ming-bot/Swan-Plan/check middle/外观图.jpg

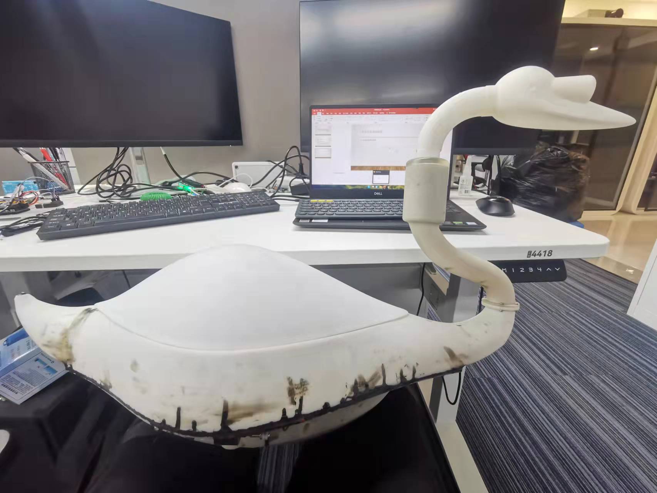
check middle/外观图.jpg
