ming-bot/Swan-Plan/check middle/2.png

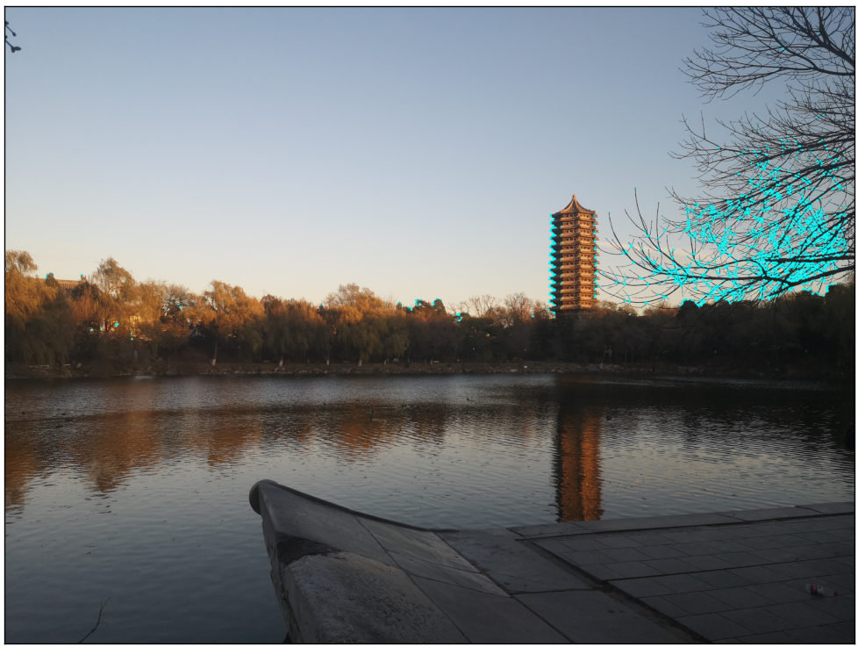
check middle/2.png
