ming-bot/Swan-Plan/README.md

# Swan-Plan

- check-middle中有中期汇报的材料，也是前段工作的总结
- 13.spi_bmi088中为控制代码
- SLAM中为纯图像识别的设想
- socket中为上位机和控制板的通信模块
