ming-bot/Swan-Plan/check middle/top.docx

JY61

communicate

Attitude speed information

Remote control information

Image information

server

By Remote control information

communicate

Raspi4B

Raspi4B

Auto cruise mode

Set PWM wave

communicate

Robomaster

Set Manual control mode

Socket

Process

communicate

communicate
