ming-bot/Swan-Plan/SLAM/系统和摄像头测试.docx

树莓派型号：Raspi4B

安装系统型号：Ubuntu mate 20.04

打开测试摄像头网址：https://chuckmails.medium.com/enable-pi-camera-with-raspberry-pi4-ubuntu-20-10-327208312f6e
