ming-bot/Swan-Plan/check middle/1-canny.png

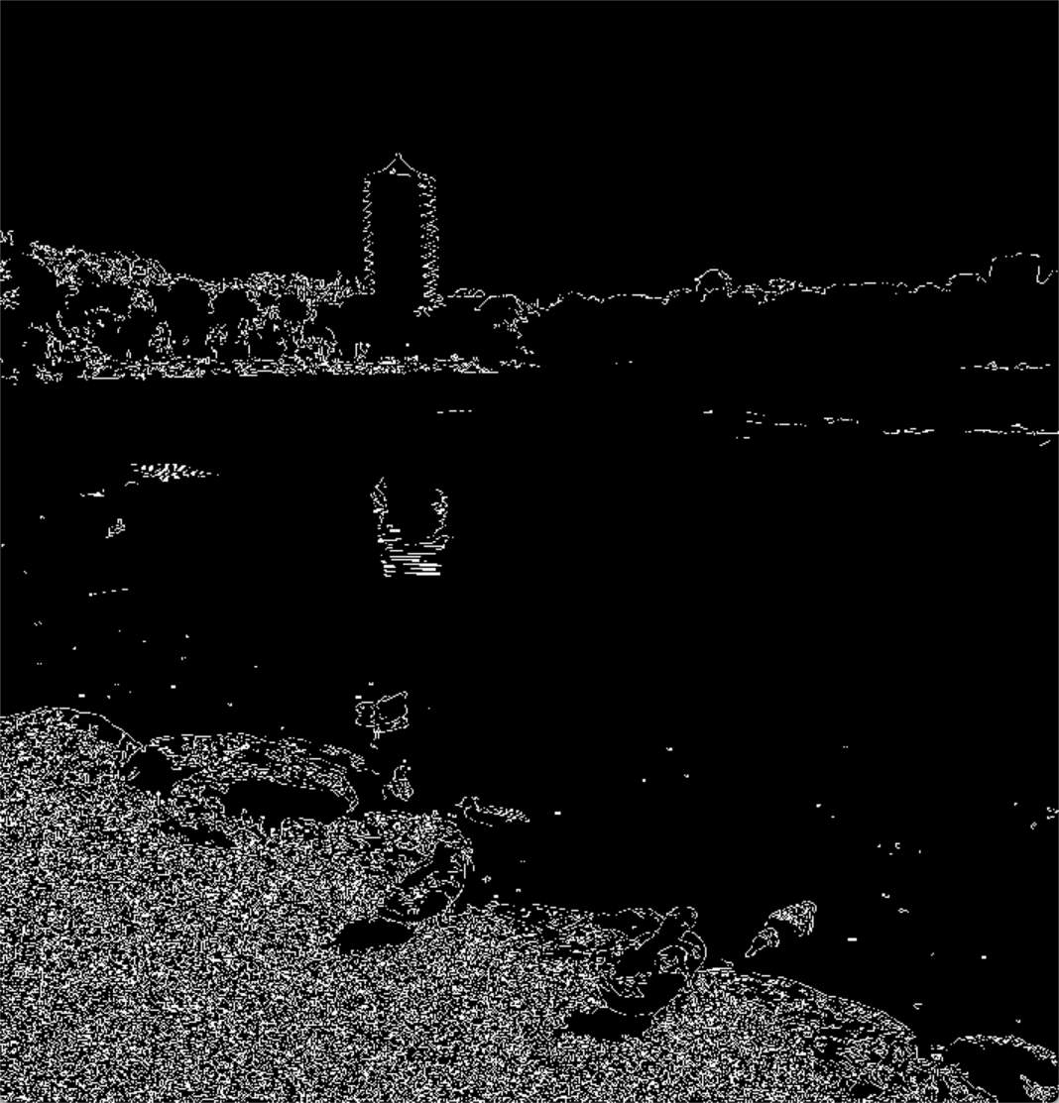
check middle/1-canny.png
