ming-bot/Swan-Plan/check middle/1.png

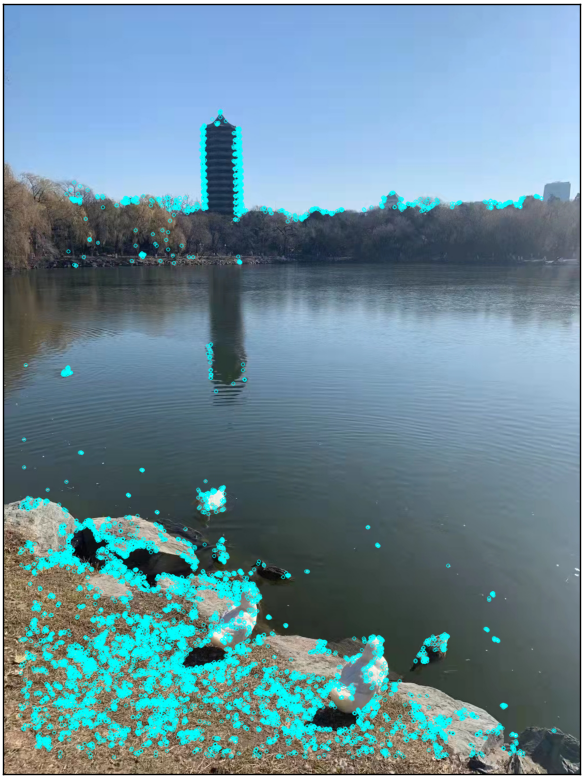
check middle/1.png
