ming-bot/Swan-Plan/check middle/2-canny.png

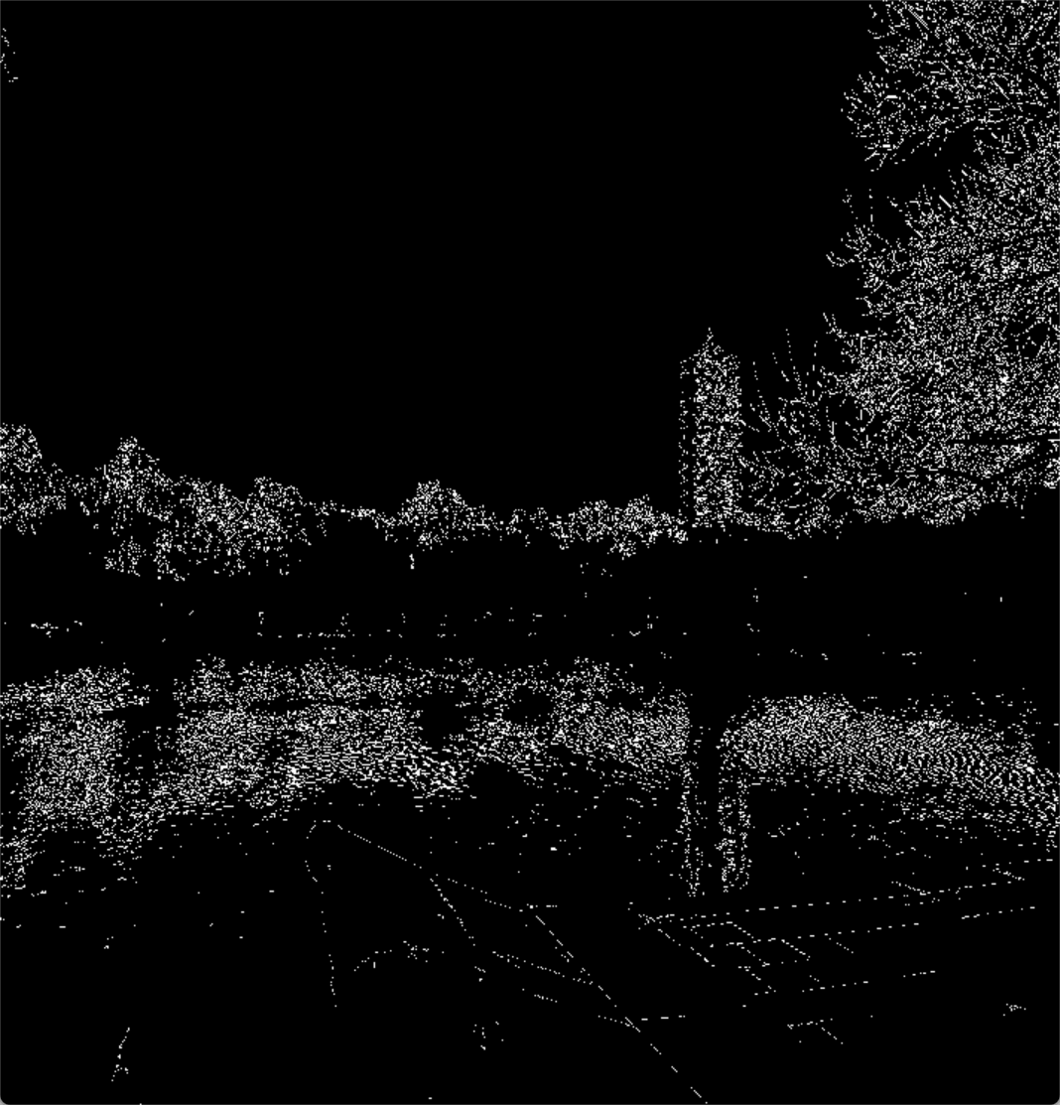
check middle/2-canny.png
