ming-bot/Swan-Plan/check middle/3-canny.png

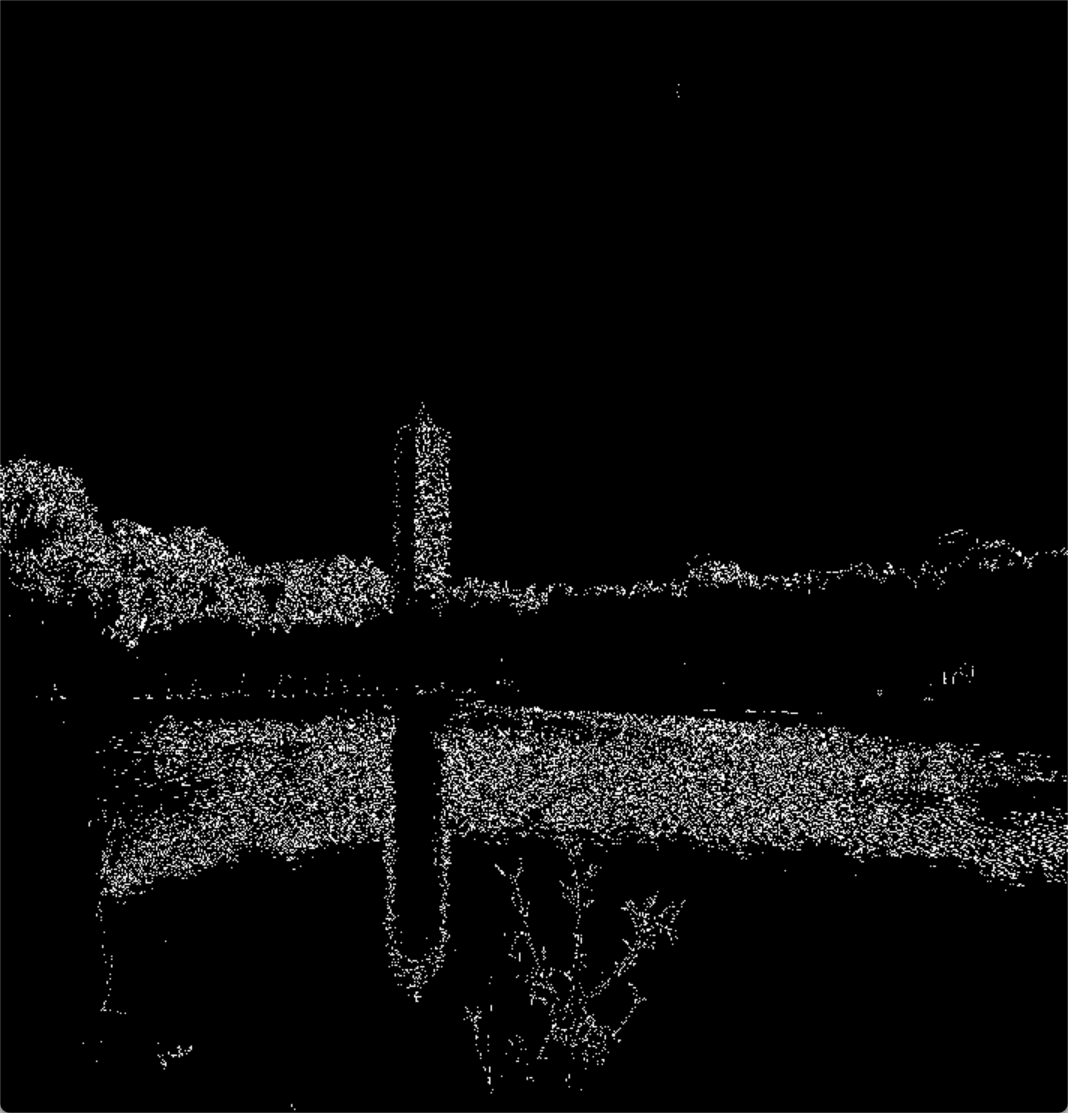
check middle/3-canny.png
