ming-bot/Swan-Plan/check middle/3.png

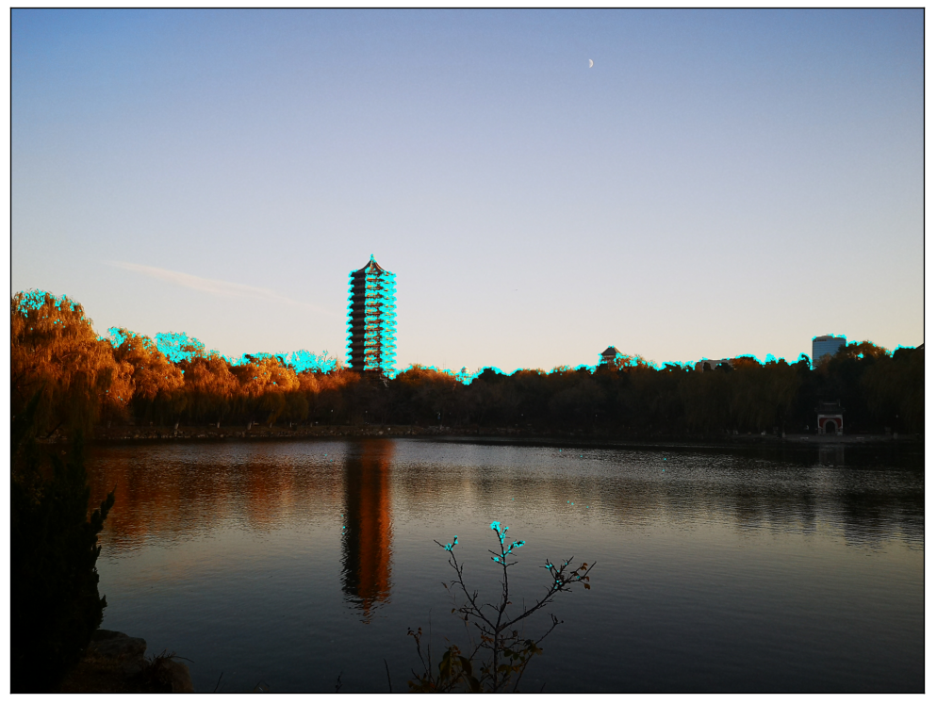
check middle/3.png
