ming-bot/Swan-Plan/check middle/CAD2.png

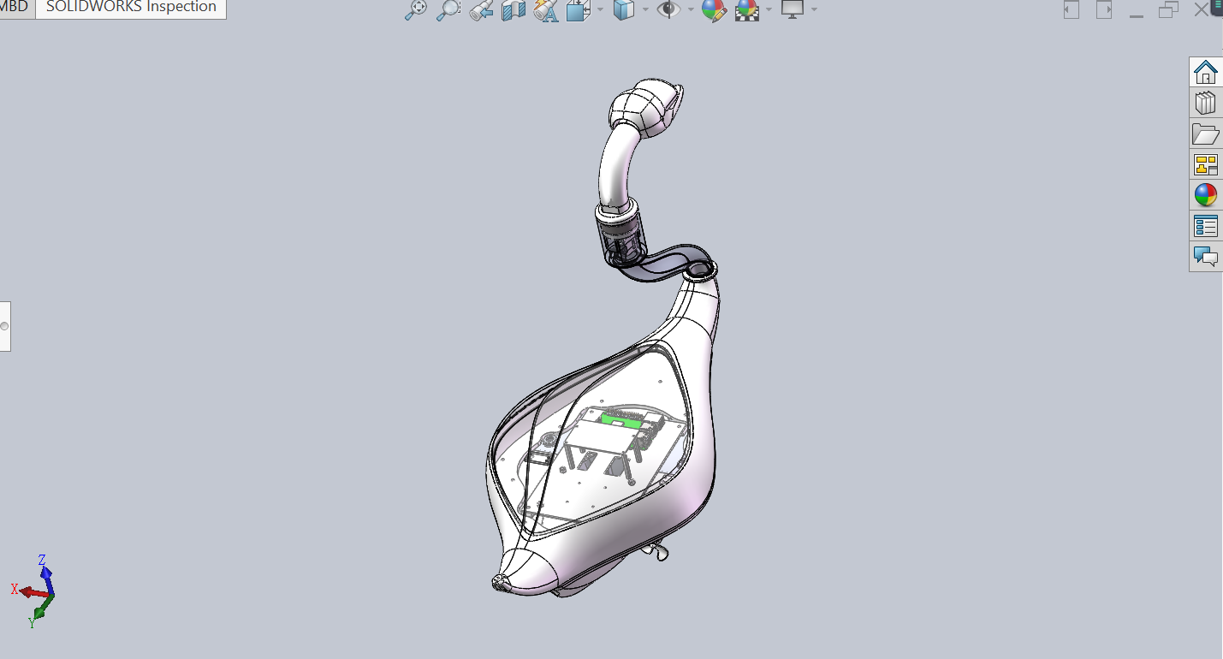
check middle/CAD2.png
