ming-bot/Swan-Plan/check middle/CAD.png

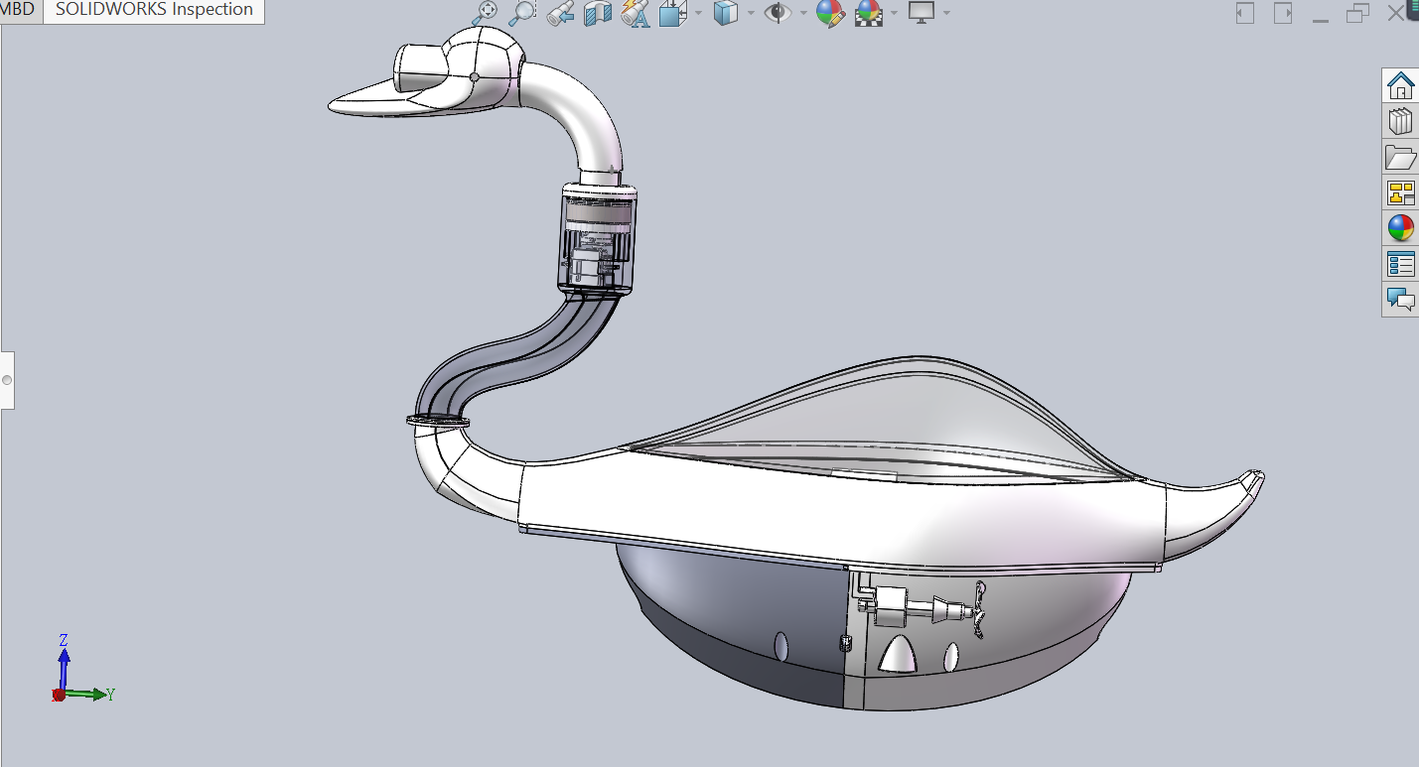
check middle/CAD.png
