ming-bot/Swan-Plan/check middle/Inked1.jpg

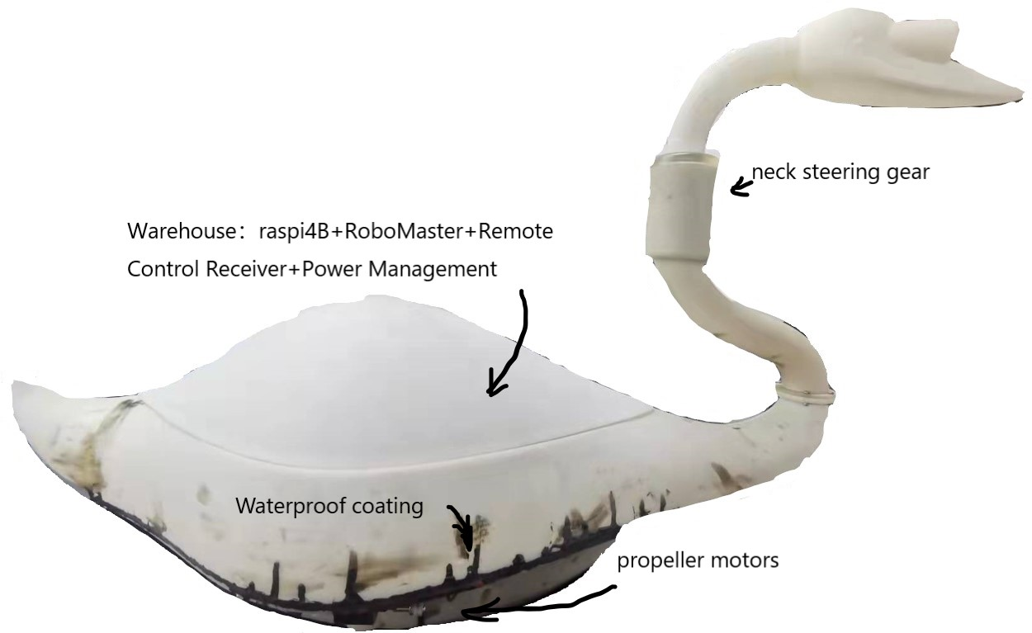
check middle/Inked1.jpg
