ming-bot/Swan-Plan/check middle/top.png

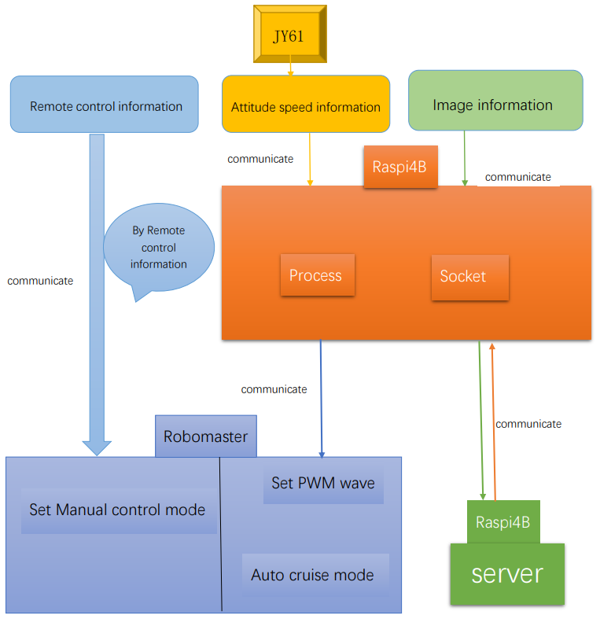
check middle/top.png
