ming-bot/Swan-Plan/SLAM/pre_img/1.jpg

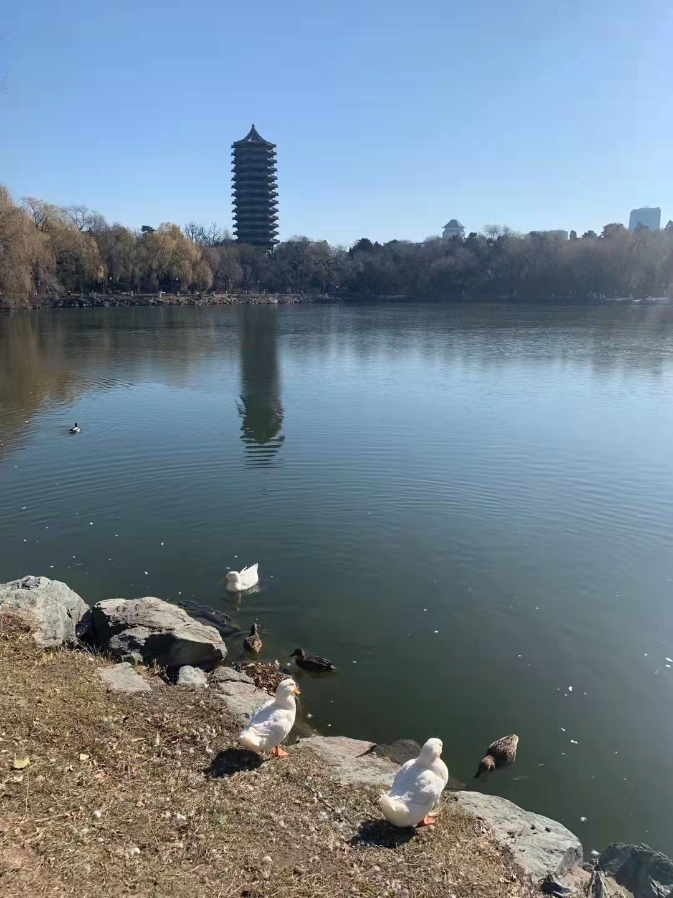
SLAM/pre_img/1.jpg
