ming-bot/Swan-Plan/SLAM/pre_img/3.jpg

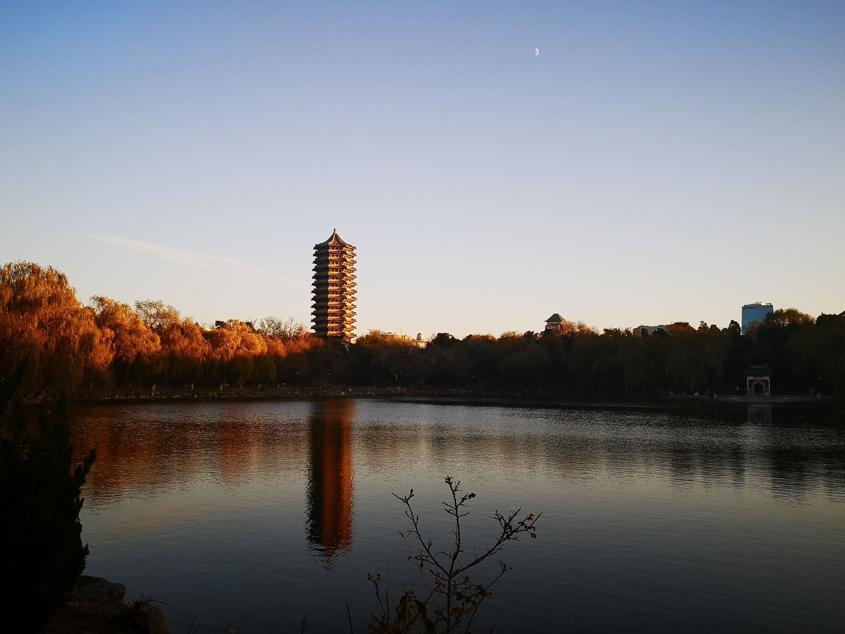
SLAM/pre_img/3.jpg
