ming-bot/Swan-Plan/未名湖天鹅计划/引脚编号.png

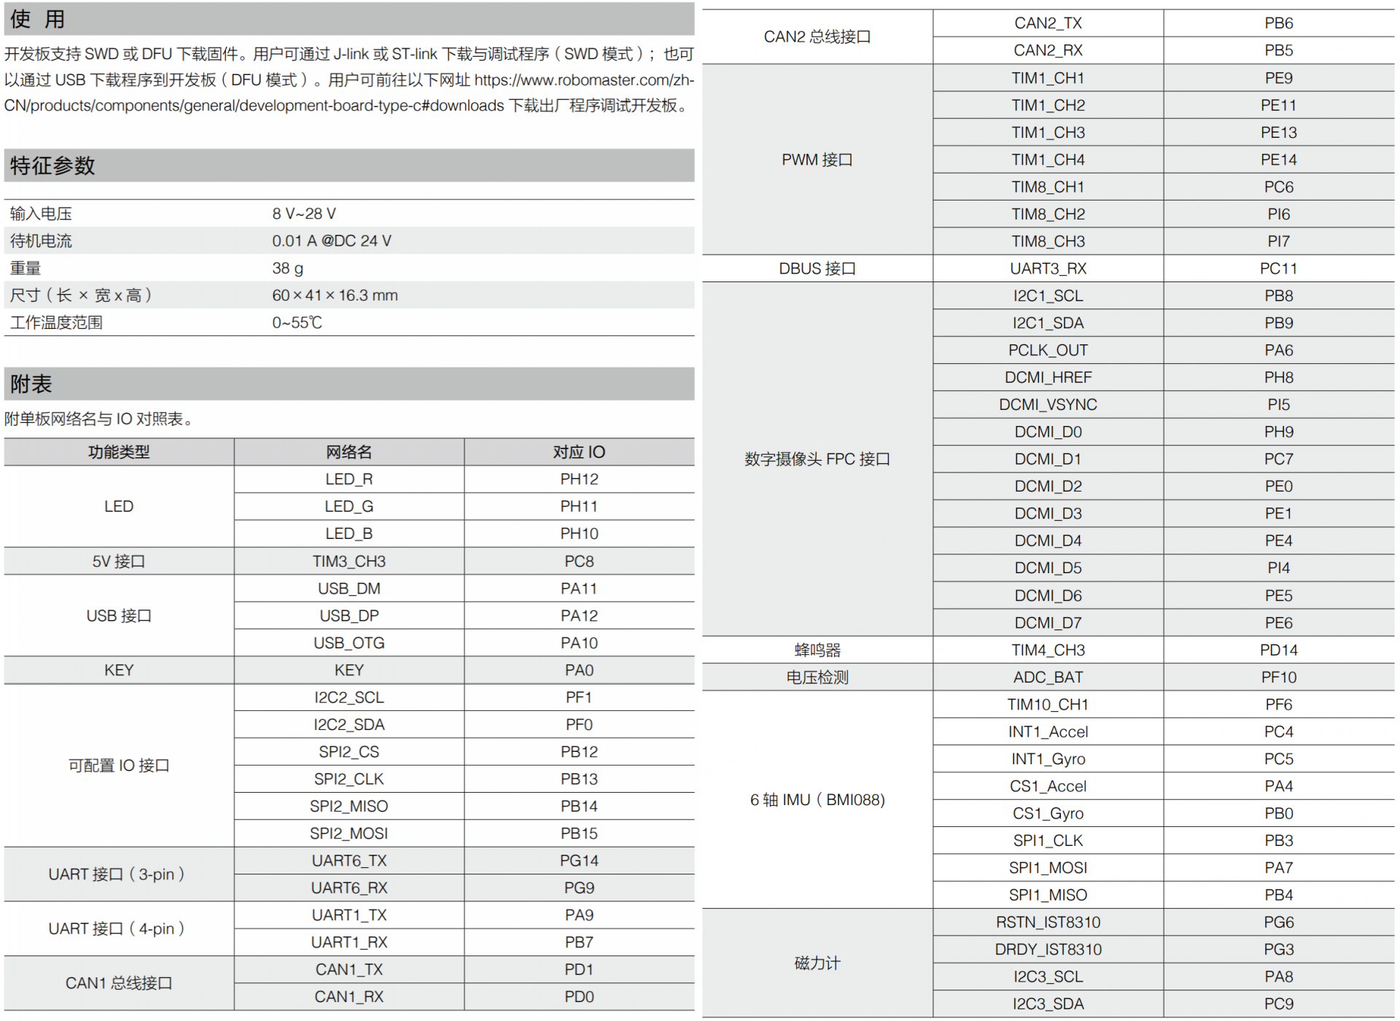
未名湖天鹅计划/引脚编号.png
