ming-bot/Swan-Plan/未名湖天鹅计划/final_building/test_bearing.SLDASM

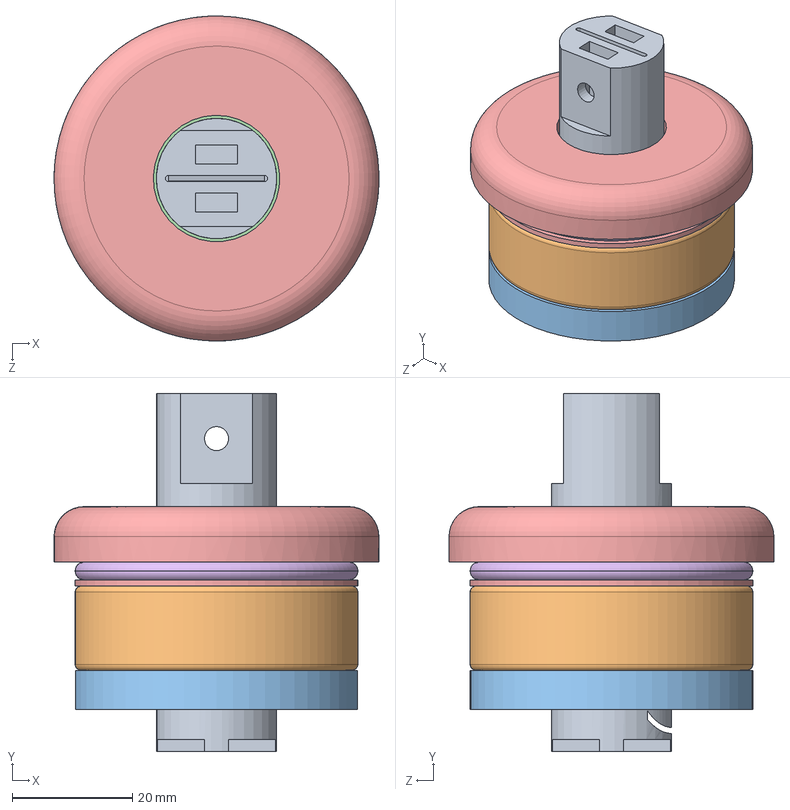
[picture p23: CAD file, 2021-12-15]
未名湖天鹅计划/final_building/test_bearing.SLDASM
54.0 x 59.5 x 54.0 mm
axis
angular contact ball bearing_68_din
Addition_bearing
Seal
cap
Seal_O
