ming-bot/Swan-Plan/未名湖天鹅计划/final_building/Thruster.SLDASM

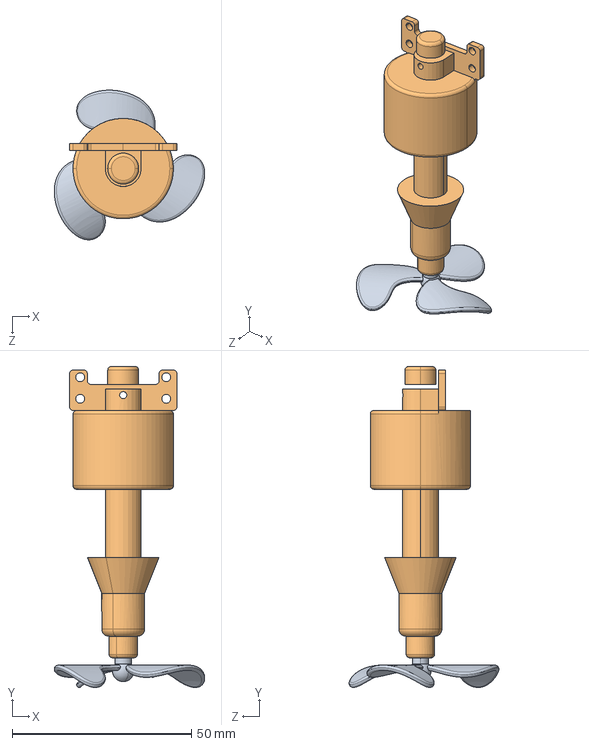
[picture p24: CAD file, 2021-12-15]
未名湖天鹅计划/final_building/Thruster.SLDASM
42.0 x 89.5 x 41.8 mm
Part2.stp
Part1.1.2.stp
