ming-bot/Swan-Plan/未名湖天鹅计划/final_building/cabin_rear.SLDPRT

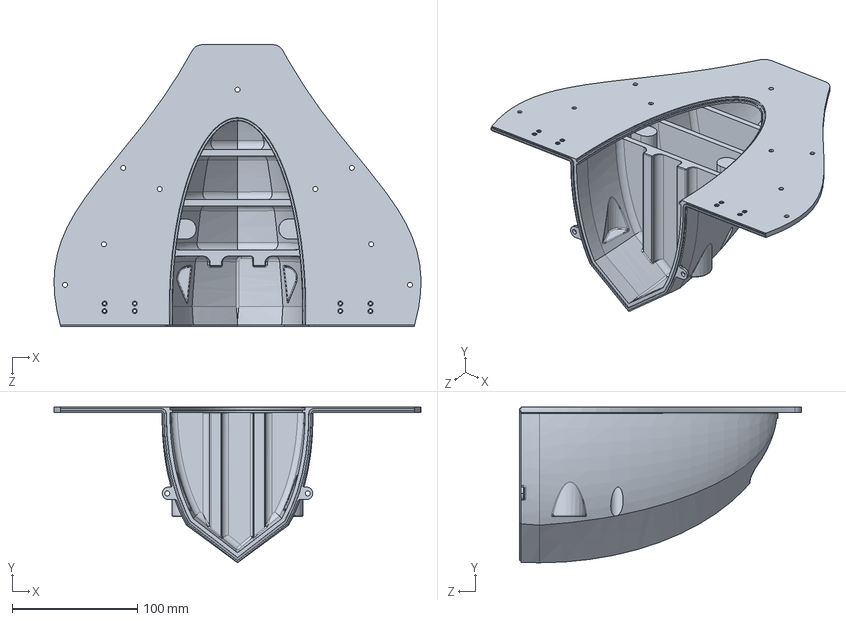
[picture p25: CAD file, 2021-12-15]
未名湖天鹅计划/final_building/cabin_rear.SLDPRT
292.5 x 124.0 x 224.6 mm
