ming-bot/Swan-Plan/未名湖天鹅计划/final_building/shell_down.stp

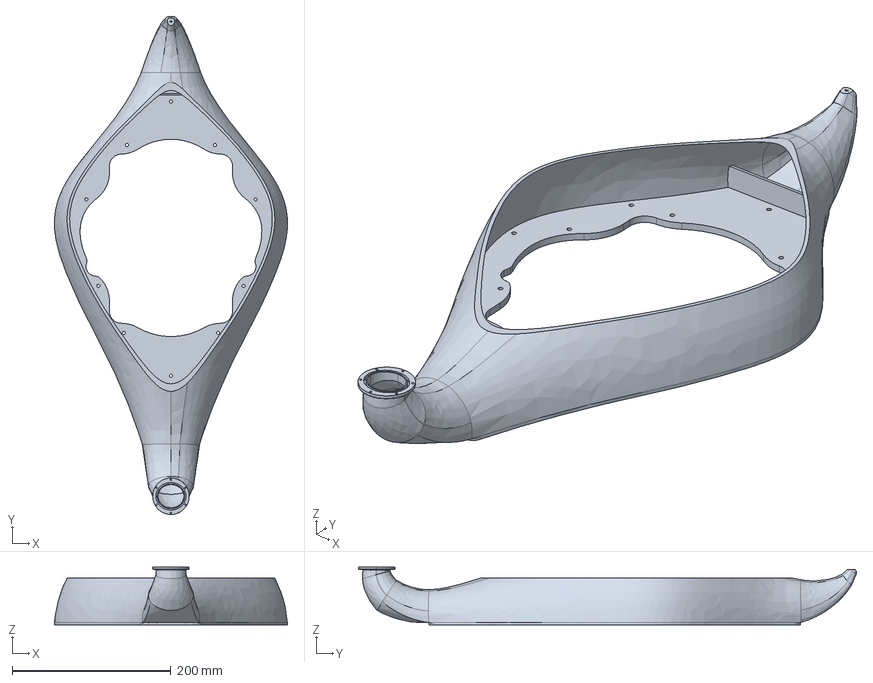
[picture p26: CAD file, 2021-12-15]
未名湖天鹅计划/final_building/shell_down.stp
293.4 x 627.2 x 73.0 mm
