ming-bot/Swan-Plan/未名湖天鹅计划/final_building/PCB板底板.SLDPRT

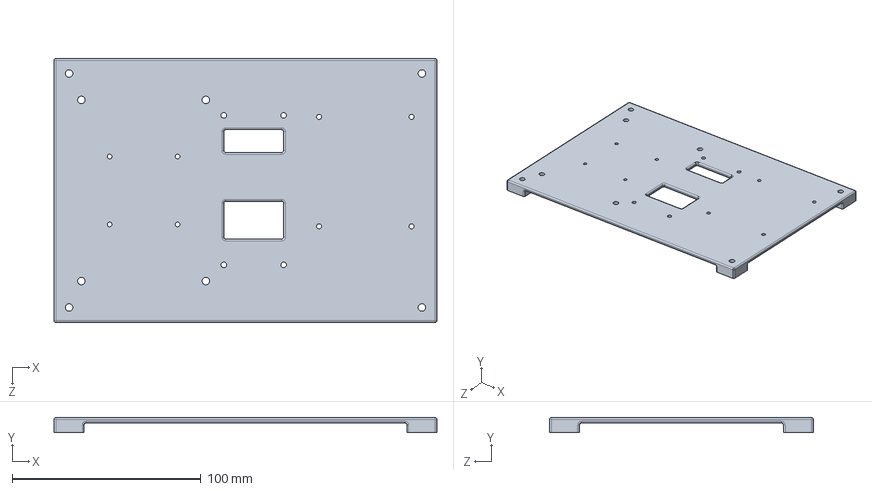
[picture p27: CAD file, 2021-12-15]
未名湖天鹅计划/final_building/PCB板底板.SLDPRT
203.0 x 8.00 x 140.0 mm
