ming-bot/Swan-Plan/未名湖天鹅计划/final_building/电机密封挡板.SLDPRT

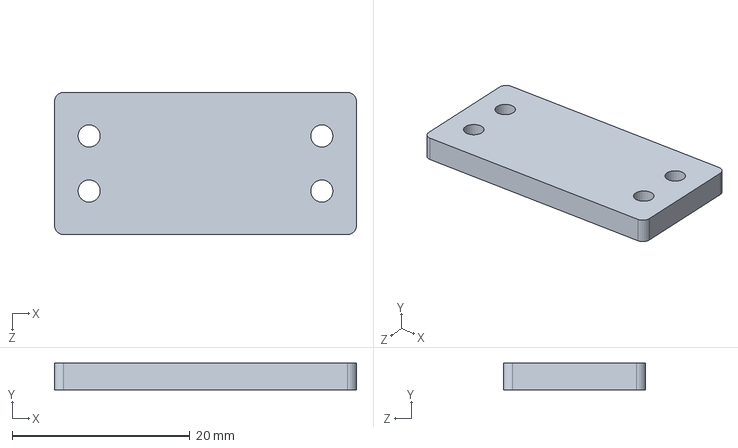
[picture p28: CAD file, 2021-12-15]
未名湖天鹅计划/final_building/电机密封挡板.SLDPRT
34.0 x 3.00 x 16.0 mm
