ming-bot/Swan-Plan/未名湖天鹅计划/final_building/电源管理板.SLDPRT

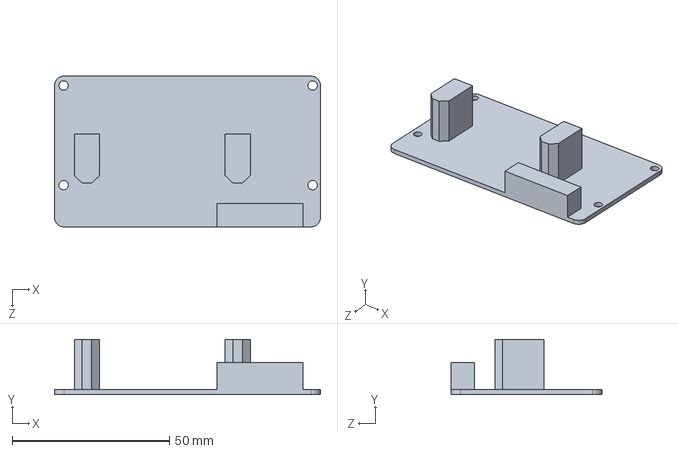
[picture p29: CAD file, 2021-12-15]
未名湖天鹅计划/final_building/电源管理板.SLDPRT
84.7 x 17.6 x 48.0 mm
