ming-bot/Swan-Plan/未名湖天鹅计划/final_building/connector_new.SLDPRT

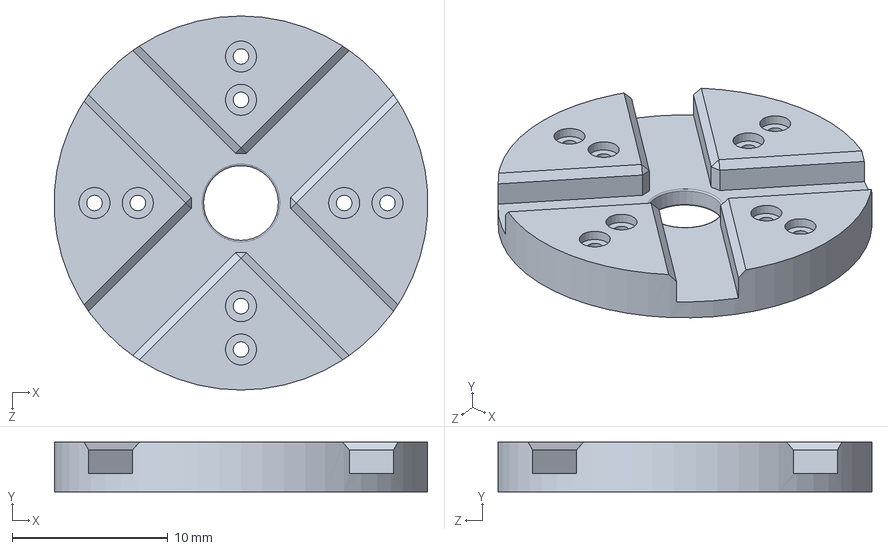
[picture p30: CAD file, 2021-12-15]
未名湖天鹅计划/final_building/connector_new.SLDPRT
24.0 x 3.18 x 24.0 mm
