ming-bot/Swan-Plan/未名湖天鹅计划/final_building/carbin_for.SLDPRT

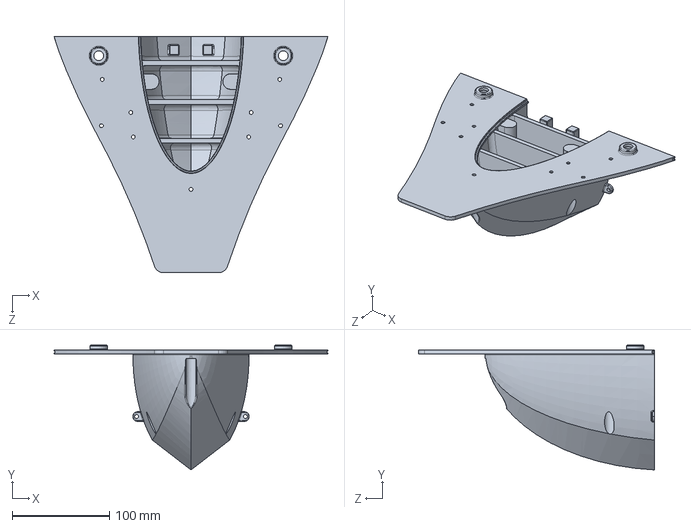
[picture p31: CAD file, 2021-12-15]
未名湖天鹅计划/final_building/carbin_for.SLDPRT
282.3 x 128.6 x 243.5 mm
