ming-bot/Swan-Plan/未名湖天鹅计划/final_building/角支撑.SLDPRT

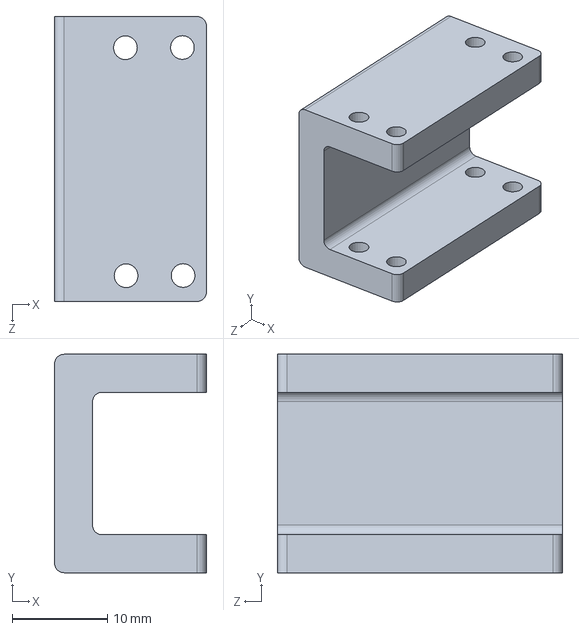
[picture p32: CAD file, 2021-12-15]
未名湖天鹅计划/final_building/角支撑.SLDPRT
16.0 x 23.0 x 30.0 mm
