ming-bot/Swan-Plan/未名湖天鹅计划/final_building/Addition_bearing.SLDPRT

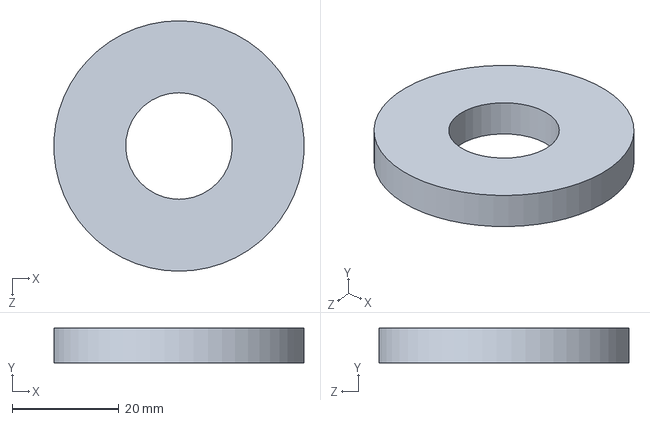
[picture p33: CAD file, 2021-12-15]
未名湖天鹅计划/final_building/Addition_bearing.SLDPRT
46.9 x 6.50 x 47.0 mm
