ming-bot/Swan-Plan/未名湖天鹅计划/final_building/cap.SLDPRT

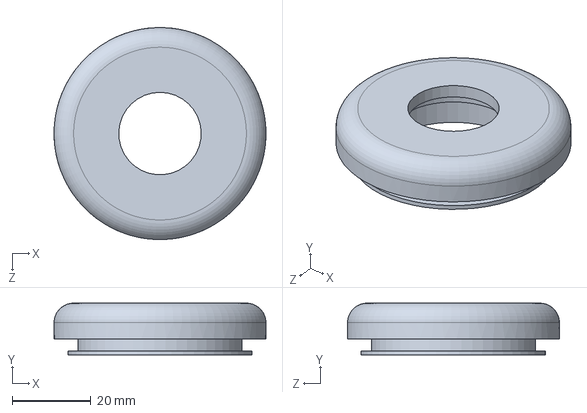
[picture p34: CAD file, 2021-12-15]
未名湖天鹅计划/final_building/cap.SLDPRT
54.0 x 13.2 x 54.0 mm
