ming-bot/Swan-Plan/未名湖天鹅计划/final_building/SwanBottom.stp

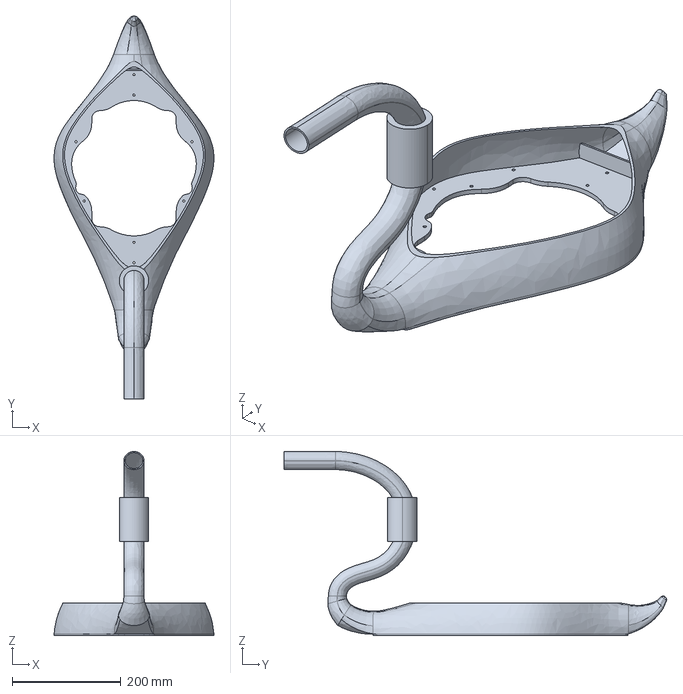
[picture p35: CAD file, 2021-12-15]
未名湖天鹅计划/final_building/SwanBottom.stp
293.4 x 702.1 x 337.7 mm
