ming-bot/Swan-Plan/未名湖天鹅计划/final_building/rid_new.SLDPRT

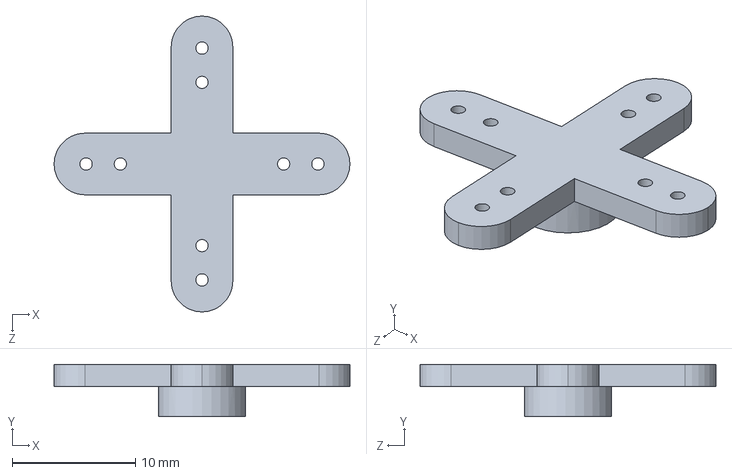
[picture p36: CAD file, 2021-12-15]
未名湖天鹅计划/final_building/rid_new.SLDPRT
24.0 x 4.22 x 24.0 mm
