ming-bot/Swan-Plan/未名湖天鹅计划/final_building/angular contact ball bearing_68_din.sldprt

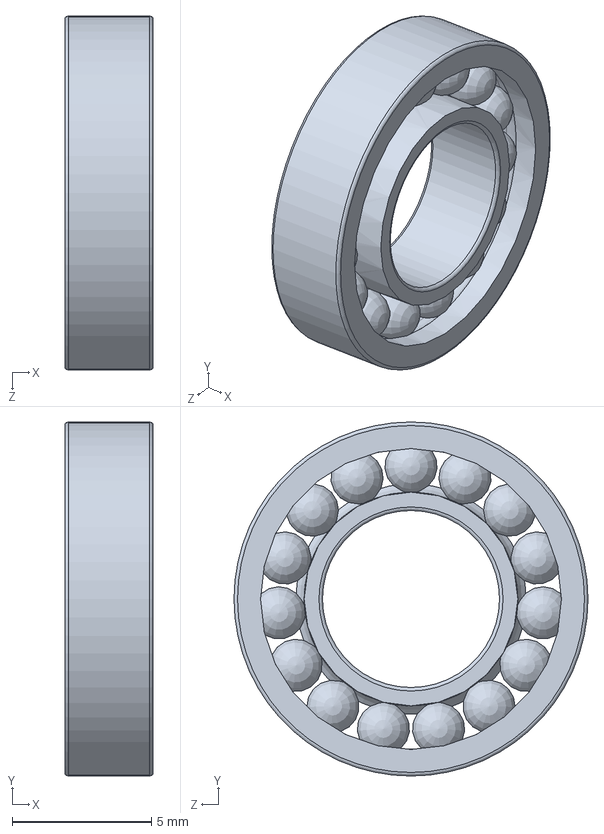
[picture p37: CAD file, 2021-12-15]
未名湖天鹅计划/final_building/angular contact ball bearing_68_din.sldprt
3.17 x 12.7 x 12.7 mm
