ming-bot/Swan-Plan/未名湖天鹅计划/final_building/KST-DS3..DM.stp

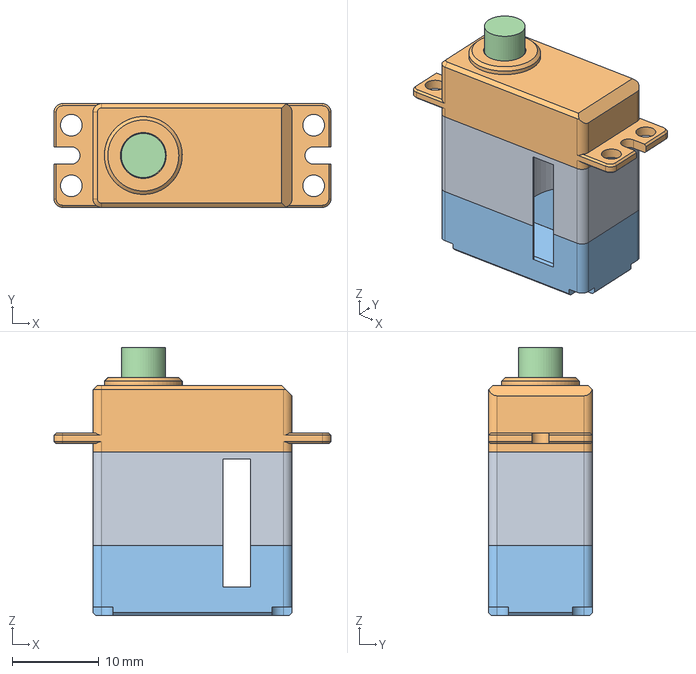
[picture p38: CAD file, 2021-12-15]
未名湖天鹅计划/final_building/KST-DS3..DM.stp
32.0 x 12.0 x 31.0 mm
