ming-bot/Swan-Plan/未名湖天鹅计划/final_building/axis.SLDPRT

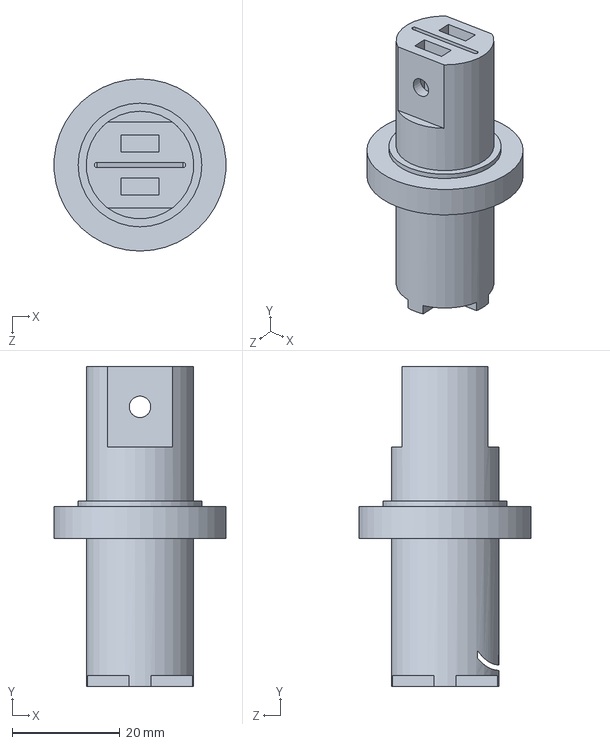
[picture p39: CAD file, 2021-12-15]
未名湖天鹅计划/final_building/axis.SLDPRT
31.9 x 59.5 x 32.0 mm
