ming-bot/Swan-Plan/未名湖天鹅计划/final_building/hex nuts, style 1-grades ab gb.sldprt

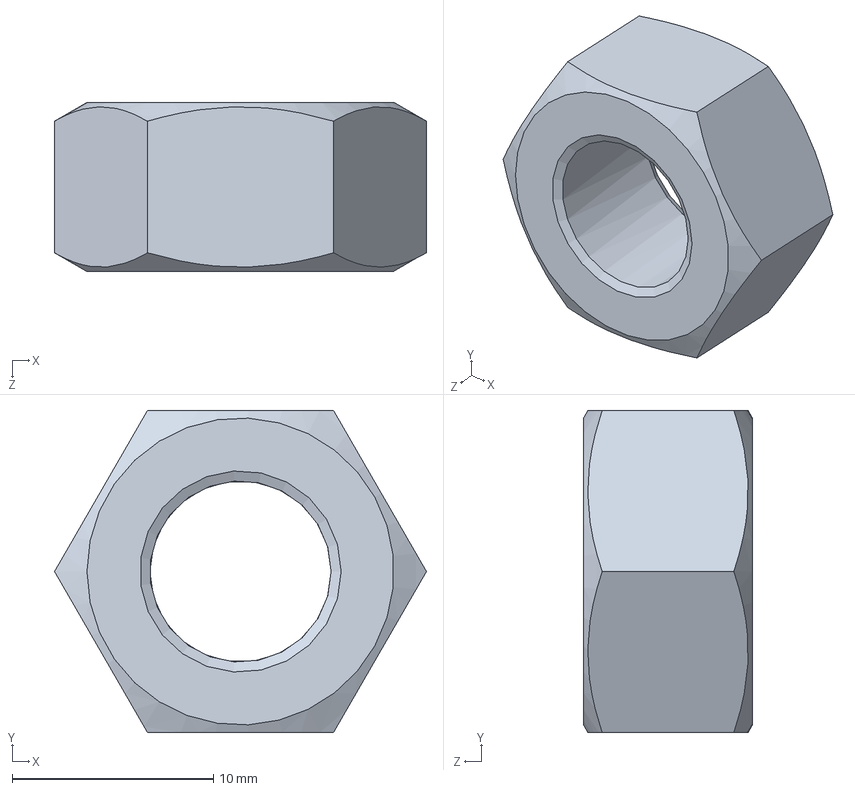
[picture p40: CAD file, 2021-12-15]
未名湖天鹅计划/final_building/hex nuts, style 1-grades ab gb.sldprt
18.5 x 16.0 x 8.40 mm
