ming-bot/Swan-Plan/未名湖天鹅计划/final_building/Seal_O.SLDPRT

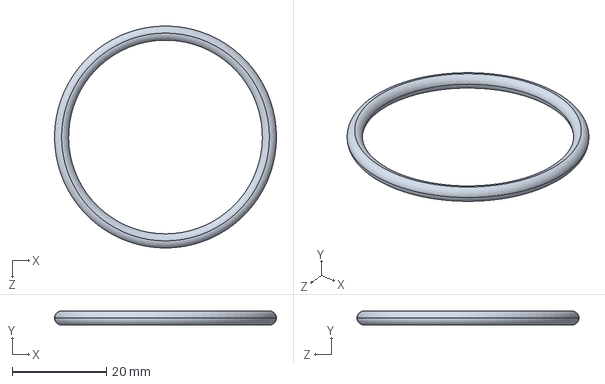
[picture p41: CAD file, 2021-12-15]
未名湖天鹅计划/final_building/Seal_O.SLDPRT
47.0 x 3.00 x 47.0 mm
