ming-bot/Swan-Plan/未名湖天鹅计划/final_building/Shell_mid.SLDPRT

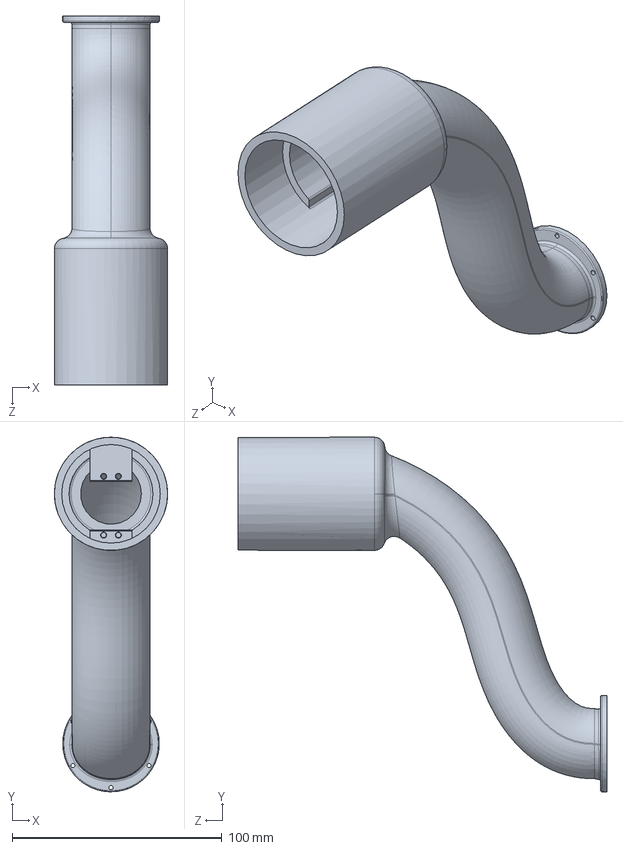
[picture p42: CAD file, 2021-12-15]
未名湖天鹅计划/final_building/Shell_mid.SLDPRT
54.0 x 169.1 x 175.9 mm
