ming-bot/Swan-Plan/未名湖天鹅计划/final_building/SwanLid.stp

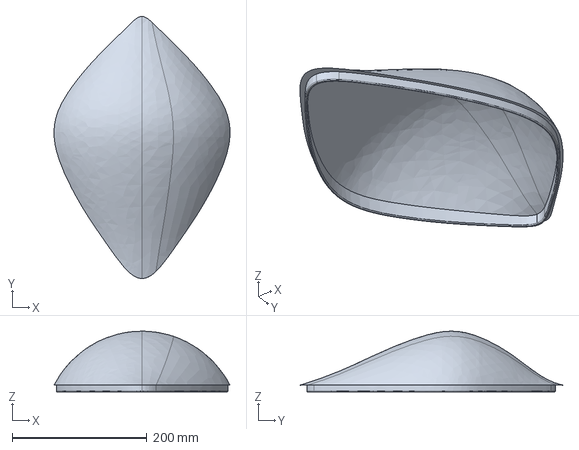
[picture p43: CAD file, 2021-12-15]
未名湖天鹅计划/final_building/SwanLid.stp
261.4 x 389.2 x 90.2 mm
