ming-bot/Swan-Plan/未名湖天鹅计划/final_building/Seal.SLDPRT

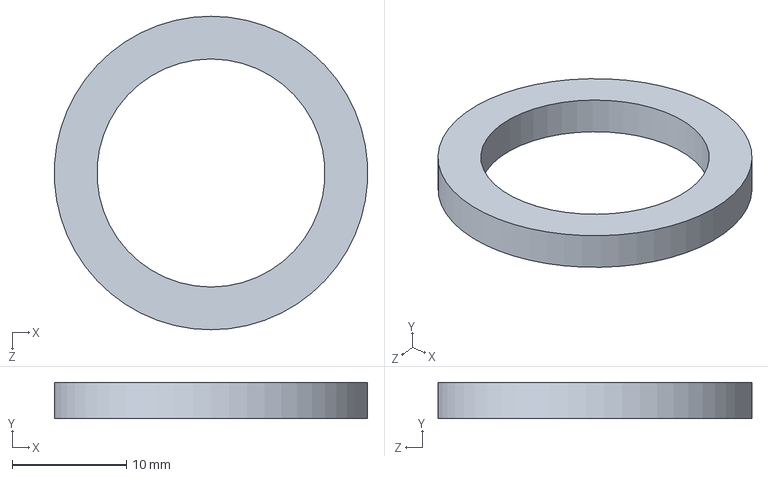
[picture p44: CAD file, 2021-12-15]
未名湖天鹅计划/final_building/Seal.SLDPRT
27.5 x 3.20 x 27.5 mm
