ming-bot/Swan-Plan/未名湖天鹅计划/final_building/舱体盖板.SLDPRT

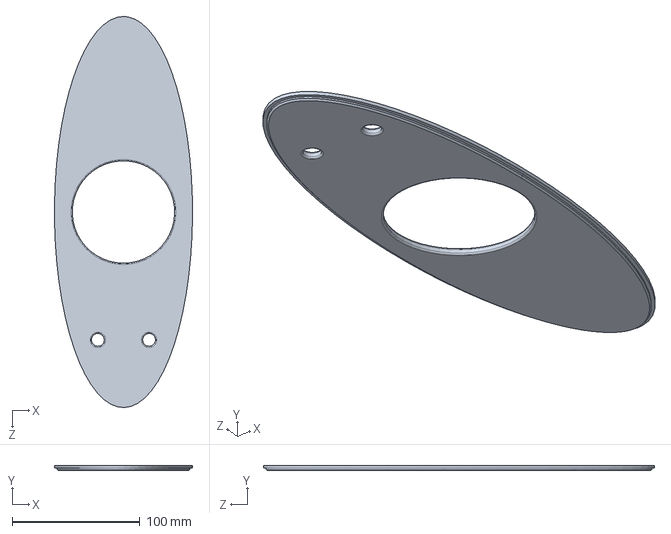
[picture p45: CAD file, 2021-12-15]
未名湖天鹅计划/final_building/舱体盖板.SLDPRT
107.9 x 4.00 x 305.8 mm
