ming-bot/Swan-Plan/未名湖天鹅计划/final_building/cabin.SLDPRT

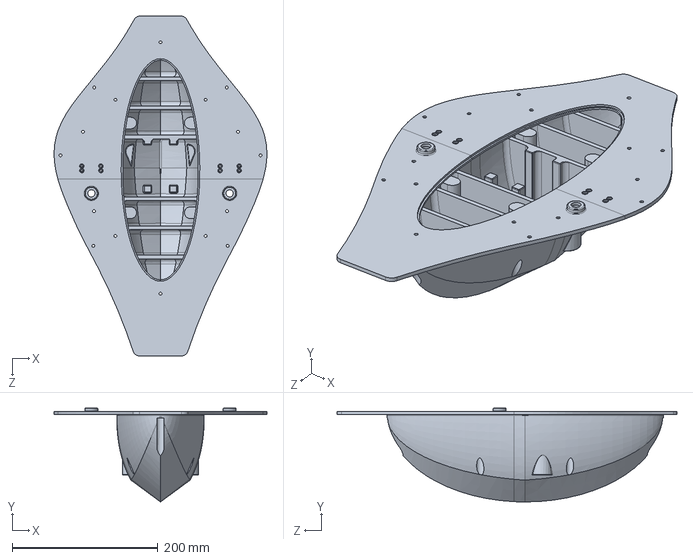
[picture p46: CAD file, 2021-12-15]
未名湖天鹅计划/final_building/cabin.SLDPRT
292.5 x 129.0 x 467.1 mm
