ming-bot/Swan-Plan/(list of files, cad)

Other CAD files:
未名湖天鹅计划/final_building/Part 1.stp.SLDPRT
未名湖天鹅计划/final_building/Part 1-8.stp.SLDPRT
未名湖天鹅计划/final_building/Part 1-2.stp.SLDPRT
未名湖天鹅计划/final_building/CUI_PJ-102A-18.stp.SLDPRT
未名湖天鹅计划/final_building/SOIC_8_39x49mm_P127mm.stp.SLDPRT
未名湖天鹅计划/final_building/CP_Elec_5x53.stp.SLDPRT
未名湖天鹅计划/final_building/Part 1-4.stp.SLDPRT
未名湖天鹅计划/final_building/TO_263_5_TabPin3.stp.SLDPRT
未名湖天鹅计划/final_building/Part 1-0.stp.SLDPRT
未名湖天鹅计划/final_building/USB_Micro-B_Molex_47346-0001-11.stp.SLDPRT
未名湖天鹅计划/final_building/HTSSOP_28_1EP_44x97mm_P065mm.stp.SLDPRT
未名湖天鹅计划/final_building/SW_DIP_SPSTx02_Slide_Copal_CHS_02B_W762mm_P127mm.stp.SLDPRT
未名湖天鹅计划/final_building/Thruster_L.stp
未名湖天鹅计划/final_building/USB_Micro-B_Molex_47346-0001-10.stp.SLDPRT
未名湖天鹅计划/final_building/JST_B3B_EH_A.stp.SLDPRT
未名湖天鹅计划/final_building/Part 1-6.stp.SLDPRT
未名湖天鹅计划/final_building/JST_B4B_EH_A.stp.SLDPRT
未名湖天鹅计划/final_building/CUI_PJ-102A-21.stp.SLDPRT
未名湖天鹅计划/final_building/Part 1-19.stp.SLDPRT
未名湖天鹅计划/final_building/PinHeader_2x10_P254mm_Vertical.stp.SLDPRT
未名湖天鹅计划/final_building/PinSocket_1x06_P254mm_Vertical.stp.SLDPRT
未名湖天鹅计划/final_building/LM1117.stp.SLDPRT
未名湖天鹅计划/final_building/TO_263_2.stp.SLDPRT
未名湖天鹅计划/final_building/LED_0603_1608Metric.stp.SLDPRT
未名湖天鹅计划/final_building/PinHeader_2x05_P200mm_Vertical.stp.SLDPRT
未名湖天鹅计划/final_building/Part 1-5.stp.SLDPRT
未名湖天鹅计划/final_building/Part 1-1.stp.SLDPRT
未名湖天鹅计划/final_building/CP_Elec_10x10.stp.SLDPRT
未名湖天鹅计划/final_building/PinHeader_1x02_P200mm_Vertical.stp.SLDPRT
未名湖天鹅计划/final_building/USB_Micro-B_Molex_47346-0001-14.stp.SLDPRT
未名湖天鹅计划/final_building/USB_Micro-B_Molex_47346-0001-13.stp.SLDPRT
未名湖天鹅计划/final_building/TO_252_2.stp.SLDPRT
未名湖天鹅计划/final_building/USB_Micro-B_Molex_47346-0001-12.stp.SLDPRT
未名湖天鹅计划/final_building/CUI_PJ-102A.stp.SLDPRT
未名湖天鹅计划/final_building/USB_Micro-B_Molex_47346-0001-15.stp.SLDPRT
未名湖天鹅计划/final_building/PinHeader_2x03_P254mm_Vertical.stp.SLDPRT
未名湖天鹅计划/final_building/USB_Micro-B_Molex_47346-0001-9.stp.SLDPRT
未名湖天鹅计划/final_building/Shell.SLDPRT
未名湖天鹅计划/final_building/QFN-24_3x3mm_Pitch0.4mm.stp.SLDPRT
未名湖天鹅计划/final_building/PinSocket_1x08_P254mm_Vertical.stp.SLDPRT
未名湖天鹅计划/final_building/SMW250-02_P2-5_L7-4_W5-8_H7.stp.SLDPRT
未名湖天鹅计划/final_building/LQFP_144_20x20mm_P05mm.stp.SLDPRT
未名湖天鹅计划/final_building/USB_Micro-B_Molex_47346-0001.stp.SLDPRT
未名湖天鹅计划/final_building/Part 1-17.stp.SLDPRT
未名湖天鹅计划/final_building/PinSocket_1x10_P254mm_Vertical.stp.SLDPRT
未名湖天鹅计划/final_building/Part 1-20.stp.SLDPRT
未名湖天鹅计划/final_building/SOT_223.stp.SLDPRT
未名湖天鹅计划/final_building/CUI_PJ-102A-7.stp.SLDPRT
未名湖天鹅计划/final_building/CP_Elec_8x10.stp.SLDPRT
未名湖天鹅计划/final_building/Part 1-3.stp.SLDPRT
未名湖天鹅计划/final_building/USB_Micro-B_Molex_47346-0001-16.stp.SLDPRT
未名湖天鹅计划/final_building/PinHeader_2x05_P127mm_Vertical.stp.SLDPRT
未名湖天鹅计划/final_building/022035025.stp.SLDPRT
未名湖天鹅计划/final_building/530470210.stp.SLDPRT
未名湖天鹅计划/final_building/KST-DS3..DM.SLDPRT
未名湖天鹅计划/final_building/M2_5尼龙螺柱.SLDPRT
未名湖天鹅计划/final_building/SwanLid.SLDPRT
未名湖天鹅计划/final_building/hexagon head bolts-full thread gb.sldprt
未名湖天鹅计划/final_building/m3_40尼龙螺柱.SLDPRT
未名湖天鹅计划/final_building/m4_5尼龙螺柱.SLDPRT
未名湖天鹅计划/final_building/shell_down.SLDPRT
