ming-bot/Swan-Plan/13.spi_bmi088/spi_bmi088.ioc

Mcu.UserName=STM32F407IGHx
PA13.Signal=SYS_JTMS-SWDIO
PA14.Signal=SYS_JTCK-SWCLK
PA4.GPIO_Label=CS1_ACCEL
PA4.Signal=GPIO_Output
PA7.Signal=SPI1_MOSI
PA9.Signal=USART1_TX
PB0.GPIO_Label=CS1_GYRO
PB0.Signal=GPIO_Output
PB14.Signal=S_TIM12_CH1
PB15.Signal=S_TIM12_CH2
PB3.Signal=SPI1_SCK
PB4.Signal=SPI1_MISO
PB7.Signal=USART1_RX
PC4.GPIO_Label=INT1_ACCEL
PC4.Signal=GPXTI4
PC5.GPIO_Label=INT1_GRYO
PC5.Signal=GPXTI5
PC6.Signal=S_TIM8_CH1
PE11.Signal=S_TIM1_CH2
PE13.Signal=S_TIM1_CH3
PE14.Signal=S_TIM1_CH4
PE9.Signal=S_TIM1_CH1
PF6.Signal=S_TIM10_CH1
PH0-OSC_IN.Signal=RCC_OSC_IN
PH1-OSC_OUT.Signal=RCC_OSC_OUT
PI6.Signal=S_TIM8_CH2
PI7.Signal=S_TIM8_CH3
