ming-bot/Swan-Plan/13.spi_bmi088/Src/main.c

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

/* Includes ------------------------------------------------------------------*/
#include "main.h"
#include "dma.h"
#include "spi.h"
#include "tim.h"
#include "usart.h"
#include "gpio.h"

/* USER CODE BEGIN Includes */
#include "BMI088driver.h"
#include "control_get.h"
#include "Get_Angle.h"
/* USER CODE END Includes */


void SystemClock_Config(void);
/* USER CODE BEGIN PFP */

/* USER CODE BEGIN PFP */
/* USER CODE BEGIN 0 */
//uint8_t NumberCount = 0;
//uint8_t ReceiveResult = 0;
//uint8_t receive_loop = 0;

//uint8_t high[4];//调试使用
//uint32_t capture_Buf[2] = {0,0}; //left_right
//uint32_t capture_buf[2] = {0,0};//back_front
//uint32_t capture_Buf_12[2] = {0,0}; //channal_5
//uint32_t capture_buf_12[2] = {0,0};//channal_6
uint8_t capture_Cnt_8[2] = {0,0};    
uint8_t capture_Cnt_12[2] = {0,0};
fp32 gyro[3], accel[3], temp, Euler_Angles[3];
float q[4] ;
//uint32_t high_time_left_right;		
//uint32_t high_time_back_front;
//uint32_t high_time_chanal_5;
//uint32_t high_time_channal_6;
//uint16_t left_right[2] = {0, 2000};
//uint16_t back_front[2] = {0, 2000};
//uint16_t back_front_PWM = 0;
//uint16_t left_right_pwm = 0;
//uint8_t channal_state_5 = 0;
//uint8_t channal_state_6 = 0;
//	

//void USART1_IRQHandler(void)  
//{
//    volatile uint8_t receive;
//    //receive interrupt 接收中断
//    if(huart1.Instance->SR & UART_FLAG_RXNE)
//    {
//        receive = huart1.Instance->DR;
//			  if(receive == 'b'){
//					NumberCount = 0;
//					ReceiveResult = 0;
//					receive_loop = 0;
//				}
//				else if(receive == 'e'){
//					receive_loop = 1;
//					/*
//					change the struct data code
//					*/
//				}
//				else{
//					int add_number = receive - '0';
//					int j = 1;
//					int weight = 1;
//					NumberCount ++ ;
//					for( j = 1; j < NumberCount; j ++){
//						weight = weight * 10;
//					
//					ReceiveResult += weight * add_number;
//					
//				}
//    }
//		
//    //idle interrupt 空闲中断
//    else if(huart1.Instance->SR & UART_FLAG_IDLE)
//    {
//        receive = huart1.Instance->DR;
//       // HAL_GPIO_WritePin(LED_R_GPIO_Port, LED_R_Pin, GPIO_PIN_RESET);
//    }

//}




/* USER CODE END 0 */
/* USER CODE END PFP */

/**
  * @brief  The application entry point.
  * @retval int
  */
int main(void)
{
  /* MCU Configuration--------------------------------------------------------*/

  /* Reset of all peripherals, Initializes the Flash interface and the Systick. */
  HAL_Init();

  /* Configure the system clock */
  SystemClock_Config();

  /* Initialize all configured peripherals */
  MX_GPIO_Init();
  MX_DMA_Init();
  MX_SPI1_Init();
  MX_TIM10_Init();
  MX_TIM1_Init();
  MX_TIM8_Init();
  MX_TIM12_Init();
  MX_USART1_UART_Init();
  /* USER CODE BEGIN 2 */
	 /* USER CODE BEGIN 2 */
    HAL_TIM_Base_Start(&htim8);
    HAL_TIM_PWM_Start(&htim8, TIM_CHANNEL_3);
		HAL_TIM_Base_Start(&htim1);
    HAL_TIM_PWM_Start(&htim1, TIM_CHANNEL_1);
    HAL_TIM_PWM_Start(&htim1, TIM_CHANNEL_2);
    HAL_TIM_PWM_Start(&htim1, TIM_CHANNEL_3);
    HAL_TIM_PWM_Start(&htim1, TIM_CHANNEL_4);
		
		
//    HAL_GPIO_WritePin(LED_R_GPIO_Port, LED_R_Pin, GPIO_PIN_RESET);
//    HAL_GPIO_WritePin(LED_G_GPIO_Port, LED_G_Pin, GPIO_PIN_RESET);
//    HAL_GPIO_WritePin(LED_B_GPIO_Port, LED_B_Pin, GPIO_PIN_RESET);
    //enable receive interrupt and idle interrupt
    //使能接收中断和空闲中断
    __HAL_UART_ENABLE_IT(&huart1, UART_IT_RXNE);  //receive interrupt
    __HAL_UART_ENABLE_IT(&huart1, UART_IT_IDLE);  //idle interrupt

  /* USER CODE END 2 */

  /* Infinite loop */
  /* USER CODE BEGIN WHILE */
	  //get begin,open the rasing take;开始检测上升沿
	  __HAL_TIM_SET_CAPTUREPOLARITY(&htim8, TIM_CHANNEL_1, TIM_INPUTCHANNELPOLARITY_RISING);
		HAL_TIM_IC_Start_IT(&htim8, TIM_CHANNEL_1);
		__HAL_TIM_SET_CAPTUREPOLARITY(&htim8, TIM_CHANNEL_2, TIM_INPUTCHANNELPOLARITY_RISING);
		HAL_TIM_IC_Start_IT(&htim8, TIM_CHANNEL_2);
		__HAL_TIM_SET_CAPTUREPOLARITY(&htim12, TIM_CHANNEL_1, TIM_INPUTCHANNELPOLARITY_RISING);
		HAL_TIM_IC_Start_IT(&htim12, TIM_CHANNEL_1);
		__HAL_TIM_SET_CAPTUREPOLARITY(&htim12, TIM_CHANNEL_2, TIM_INPUTCHANNELPOLARITY_RISING);
		HAL_TIM_IC_Start_IT(&htim12, TIM_CHANNEL_2);
		capture_Cnt_8[0] = 1;
		capture_Cnt_8[1] = 1;
		capture_Cnt_12[0] = 1;
		capture_Cnt_12[1] = 1;
		
    while(BMI088_init())
    {
        ;
    }
  /* USER CODE END 2 */

  /* Infinite loop */
  /* USER CODE BEGIN WHILE */
  while (1)
  {
    /* USER CODE END WHILE */

    /* USER CODE BEGIN 3 */
				BMI088_read(gyro, accel, &temp);
		    MahonyAHRSupdateIMU(gyro[0], gyro[1], gyro[2], accel[0], accel[1], accel[2]);
        HAL_Delay(10);
  }
  /* USER CODE END 3 */
}

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
