ming-bot/Swan-Plan/未名湖天鹅计划/Aruidno/Aruidno/IMU_Read_RollPitchYaw/IMU_Read_RollPitchYaw.ino

  Range   : Roll  : +/- 180 deg/sec
            Pitch : +/- 180 deg/sec
            Yaw   : +/- 180 deg/sec
  Scale   : Roll  : 1 = 1 deg/sec
            Pitch : 1 = 1 deg/sec
            Yaw   : 1 = 1 deg/sec
 */

#include <IMU.h>


cIMU    IMU;



uint8_t   err_code;
uint8_t   led_tog = 0;
uint8_t   led_pin = 13;

void setup()
{
  Serial.begin(115200);

  IMU.begin();

  pinMode( led_pin, OUTPUT );
}





void loop()
{
  static uint32_t tTime[3];
  static uint32_t imu_time = 0;


  if( (millis()-tTime[0]) >= 500 )
  {
    tTime[0] = millis();

    digitalWrite( led_pin, led_tog );
    led_tog ^= 1;
  }

  tTime[2] = micros();
  if( IMU.update() > 0 ) imu_time = micros()-tTime[2];



  if( (millis()-tTime[1]) >= 50 )
  {
    tTime[1] = millis();

    Serial.print(imu_time);
    Serial.print(" ");
    Serial.print(IMU.rpy[0]);
    Serial.print(" ");
    Serial.print(IMU.rpy[1]);
    Serial.print(" ");
    Serial.println(IMU.rpy[2]);
  }


  if( Serial.available() )
  {
    char Ch = Serial.read();

    if( Ch == '1' )
    {
      Serial.println("ACC Cali Start");

      IMU.SEN.acc_cali_start();
      while( IMU.SEN.acc_cali_get_done() == false )
      {
        IMU.update();
      }

      Serial.print("ACC Cali End ");
    }
  }
}
