ming-bot/Swan-Plan/13.spi_bmi088/bsp/boards/Get_Angle.c

#include "Get_Angle.h"
#include "math.h"

extern fp32 gyro[3], accel[3], temp, Euler_Angles[3];
extern float q[4] ;
#define sampleFreq   100.0f
#define twoKpDef     (2.0f * 1.0f)
#define twoKiDef     (0.05f * 0.0f)

volatile float twoKp = twoKpDef;											// 2 * proportional gain (Kp)
volatile float twoKi = twoKiDef;											// 2 * integral gain (Ki)
volatile float q0 = 1.0f, q1 = 0.0f, q2 = 0.0f, q3 = 0.0f;					// quaternion of sensor frame relative to auxiliary frame
volatile float integralFBx = 0.0f,  integralFBy = 0.0f, integralFBz = 0.0f;	// integral error terms scaled by Ki

//四元数转换为欧拉角函数
static void QuaternionToAngleAxis(const float * quaternion, float* angle_axis) {
	const float q0 = quaternion[0];
  const float q1 = quaternion[1];
  const float q2 = quaternion[2];
  const float q3 = quaternion[3];

	Euler_Angles[0] = asin(2*(q0 * q2 - q1 * q3)) * 180.0/3.14;
	Euler_Angles[1] = atan((q0*q3+q1*q2)/(1-2*(q2*q2+q3*q3)))* 180.0/3.14;
	Euler_Angles[2] = atan((q0*q1+q3*q2)/(1-2*(q2*q2+q1*q1)))* 180.0/3.14;
}

//mahony计算四元数
void MahonyAHRSupdateIMU(float gx, float gy, float gz, float ax, float ay, float az) {
	float recipNorm;
	float halfvx, halfvy, halfvz;
	float halfex, halfey, halfez;
	float qa, qb, qc;
 
	// Compute feedback only if accelerometer measurement valid (avoids NaN in accelerometer normalisation)
	if(!((ax == 0.0f) && (ay == 0.0f) && (az == 0.0f))) {
 
		// Normalise accelerometer measurement
		recipNorm = invSqrt(ax * ax + ay * ay + az * az);
		ax *= recipNorm;
		ay *= recipNorm;
		az *= recipNorm;        
 
		// Estimated direction of gravity and vector perpendicular to magnetic flux
		halfvx = q1 * q3 - q0 * q2;
		halfvy = q0 * q1 + q2 * q3;
		halfvz = q0 * q0 - 0.5f + q3 * q3;
	
		// Error is sum of cross product between estimated and measured direction of gravity
		halfex = (ay * halfvz - az * halfvy);
		halfey = (az * halfvx - ax * halfvz);
		halfez = (ax * halfvy - ay * halfvx);
 
		// Compute and apply integral feedback if enabled
		if(twoKi > 0.0f) {
			integralFBx += twoKi * halfex * (1.0f / sampleFreq);	// integral error scaled by Ki
			integralFBy += twoKi * halfey * (1.0f / sampleFreq);
			integralFBz += twoKi * halfez * (1.0f / sampleFreq);
			gx += integralFBx;	// apply integral feedback
			gy += integralFBy;
			gz += integralFBz;
		}
		else {
			integralFBx = 0.0f;	// prevent integral windup
			integralFBy = 0.0f;
			integralFBz = 0.0f;
		}
 
		// Apply proportional feedback
		gx += twoKp * halfex;
		gy += twoKp * halfey;
		gz += twoKp * halfez;
	}
	
	// Integrate rate of change of quaternion
	gx *= (0.5f * (1.0f / sampleFreq));		// pre-multiply common factors
	gy *= (0.5f * (1.0f / sampleFreq));
	gz *= (0.5f * (1.0f / sampleFreq));
	qa = q0;
	qb = q1;
	qc = q2;
	q0 += (-qb * gx - qc * gy - q3 * gz);
	q1 += (qa * gx + qc * gz - q3 * gy);
	q2 += (qa * gy - qb * gz + q3 * gx);
	q3 += (qa * gz + qb * gy - qc * gx); 
	
	// Normalise quaternion
	recipNorm = invSqrt(q0 * q0 + q1 * q1 + q2 * q2 + q3 * q3);
	q0 *= recipNorm;
	q1 *= recipNorm;
	q2 *= recipNorm;
	q3 *= recipNorm;
	q[0] = q0;
	q[1] = q1;
	q[2] = q2;
	q[3] = q3;
	QuaternionToAngleAxis(q, Euler_Angles);
}

 
//---------------------------------------------------------------------------------------------------
// Fast inverse square-root
// See: http://en.wikipedia.org/wiki/Fast_inverse_square_root
 
float invSqrt(float x) {
	float halfx = 0.5f * x;
	float y = x;
	long i = *(long*)&y;
	i = 0x5f3759df - (i>>1);
	y = *(float*)&i;
	y = y * (1.5f - (halfx * y * y));
	return y;
}
